PapaBear1981/Growshed/hardware/enclosure/node_enclosure_base.stl

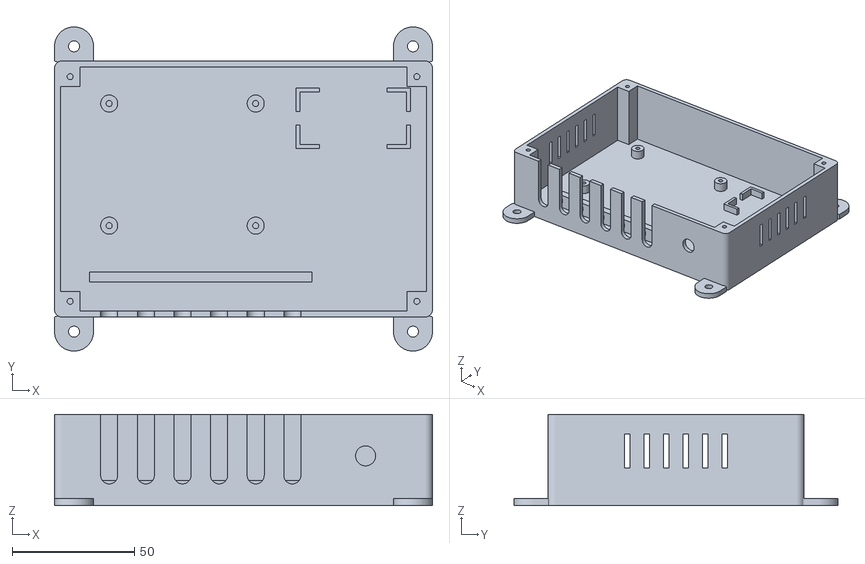
[picture p6: CAD file, 2026-11-10]
hardware/enclosure/node_enclosure_base.stl
154.8 x 132.8 x 37.4
