PapaBear1981/Growshed/hardware/enclosure/node_enclosure_lid.stl

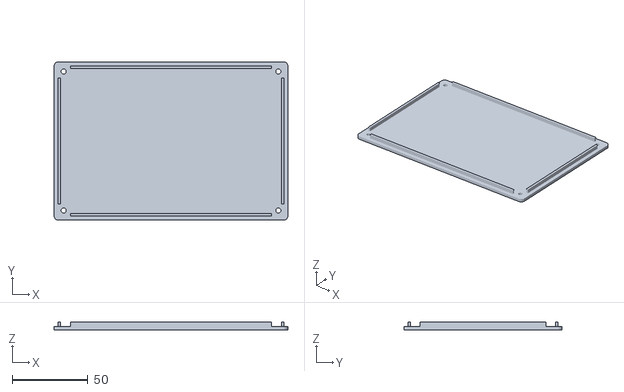
[picture p7: CAD file, 2026-11-10]
hardware/enclosure/node_enclosure_lid.stl
154.8 x 104.8 x 5.39
