PapaBear1981/Growshed/(commit log)

2026-11-10 Add project plan, architecture, safety rules, hardware and MQTT specs
    Planning docs for the Growshed controller (no code yet): phased build plan,
    Pi hub + ESPHome node architecture, node-enforced interlocks and fallbacks,
    power budget/BOM, MQTT topic contract, and CLAUDE.md for coding agents.
    Claude-Session: https://claude.ai/code/session_016ZEwZpMDaKmqs8DgSYCkPE
2026-11-10 Replan for grow tents in a finished basement
    Drop shed-specific planning (freeze protection, extension cords, insulation).
    Add per-tent nodes and zones, room humidity monitoring, spill containment,
    network-wide leak interlock, light overtemp cutoff, and basement power mapping.
    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
2026-11-10 Add printable node enclosure, node power design, and tent layout
    Parametric OpenSCAD enclosure (base + lid STLs) for an ESP32 breakout board,
    12V->5V buck converter and cable strain relief. Document 12V node power,
    the two 4x4 tents plus a dedicated tower tent, and move the tower pump and
    sensors to the tower tent's node.
    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
    [node_enclosure.scad, node_enclosure_base.stl, node_enclosure_lid.stl]
2026-11-11 Multi-board node firmware, USB board detection and GUI auto-discovery
    - firmware: ESPHome node configs (tent, tower tent, water; monitoring only)
    built from per-board profiles for ESP32, ESP32-S3, ESP32-C3, Arduino Nano
    ESP32 and ESP8266. Nodes never reboot on network loss.
    - tools/detect_boards: identify USB-connected boards and name the matching
    firmware profile, optionally probing the chip with esptool
    - GUI: boards not in config.yaml appear automatically with raw readings;
    System page shows board type and firmware; on/off states are judged by
    node liveness since ESPHome only publishes them on change
    - simulator: --extra-node to exercise discovery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
2026-11-11 Recognise Teensy boards in the USB detector
    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
2026-11-11 Phase 1: history storage and charts, alert engine, phone notifications
    - recorder: raw readings (30 d), 5-minute (1 y) and hourly summaries, with
    rollup, pruning and a grid-aligned history API
    - alerts: rule engine with hold/clear delays, unknown-state handling,
    acknowledge, repeat notifications and restart recovery; rules for leaks,
    low reservoirs, tent and water temperature, humidity, offline nodes,
    fallback mode and silent sensors
    - notify: ntfy delivery with retry, test endpoint, optional dead man's ping
    - GUI: History page (uPlot), Alerts page, critical banner on every page
    Claude-Session: https://claude.ai/code/session_0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
2026-11-11 Add build guide, generated wiring diagrams and notification setup
    - docs/BUILD.md: parts, soldering tips, bench tests, assembly, checks and
    troubleshooting for the Phase 1 sensor nodes
    - tools/wiring_diagrams: draws docs/wiring/*.svg from the firmware board
    profiles; a test fails if the committed diagrams go stale
    - ntfy and healthcheck settings in .env.example, compose and the Pi setup
    script; deploy README explains phone setup
    - recommend comparator leak-sensor modules over bare probes
    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
    [test_wiring_diagrams.py]
2026-11-11 Soil pots: moisture sensing, GUI calibration, alert, and watering rules
    - firmware: soil_sensor package (raw volts, median-filtered) and analog pin
    names in the board profiles; tent2 carries four pots by default
    - backend: two-point calibration stored in SQLite and applied to live
    values, history output and alerts; uncalibrated sensors have no value
    - GUI: soil readings on the dashboard, calibration controls on the System
    page, soil moisture chart
    - simulator: drying pots and soil faults
    - docs: wiring diagram and build steps for soil sensors; safety limits for
    Phase 2 automatic watering recorded in SAFETY.md
    Claude-Session: h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
2026-11-11 Phase 2 firmware: node-side control, interlocks and dosing limits
    - common/control.h: pure C++ control logic (mode/fallback/interlock decision,
    light window, thermostats, over-temperature latch, dose limiter) with
    native unit tests run from pytest
    - device and dose_device packages; control packages for tents (lights,
    exhaust, I-4/I-5), tower pump (I-7/I-10), water node (heater, pumps,
    top-off, I-1/2/3/8/9/10) and soil watering pumps (I-10/11/12)
    - hub leak alarm subscription, last_interlock, time zone from secrets
    - output pin names in the board profiles
    tent2, tent3 and water compile for the ESP32 DevKit.
    Claude-Session: http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
    [control_test.cpp]
2026-11-11 Phase 2 hub: device modes, settings, leak alarm latch and soil watering
    - control: auto/on/off modes with expiry, range-checked node settings, dose
    requests, and the latched house-wide leak alarm (I-10)
    - watering: dose-based auto-watering per pot with soak wait, response check,
    strike lockout, daily cap and trust checks on the reading (SAFETY 4b)
    - alerts for interlocks taking control, lights on but dark, the leak latch
    and stopped auto-watering
    - REST endpoints and WebSocket updates for the Controls page
    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
2026-11-11 Phase 2 docs: output wiring diagrams, build steps and updated specs
    - wiring diagram generator draws output diagrams (relay boxes, MOSFET
    boards) alongside the sensor diagrams; tank float added to tent2
    - BUILD.md: wiring and checking outputs, 12 V pumps, anti-siphon
    - SAFETY/ARCHITECTURE/MQTT/PLAN updated for node-local automation, the
    control topics and what is still unproven on hardware
    - firmware README: output pins, sensor-only boards, time zone
    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
2026-11-11 General sensor calibration: pH, EC, soil and offsets with steady capture
    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
2026-11-11 Phase 3 groundwork: cheap pH/EC probes, air sensor options, dosing log, journal
    - firmware: chemistry package for analog pH and TDS/EC boards (EC board
    powered only while read, so it cannot disturb pH); selectable air sensor
    packages (SHT4x, AHT20, BME280); faster soil publishing. Water node and
    AHT20/BME280 tent variants compile.
    - backend: manual dosing log, plants and journal with validated photo
    upload; pH/EC alert rules; calibration-due reminders
    - simulator: pH/EC probes with buffer and solution faults
    - GUI: general calibration component with steady-reading capture
    Claude-Session: https://claude.ai/code/session_016ZEwZp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
2026-11-11 Phase 3: Water and Journal pages, pH/EC charts, chemistry wiring and docs
    - GUI: Water page (pH, EC, temperature against targets, dosing log),
    Journal page (plants, notes, photos shrunk in the browser), pH and EC
    history with markers for logged additions, calibration display fixes
    - capture judges only the newest readings so moving a probe between
    solutions does not stall
    - wiring diagram for the pH and EC boards; BUILD.md section with the 5 V
    divider, calibration order and troubleshooting
    - docs rewritten around cheap hobby probes and their limits; stricter
    Phase 4 dosing rules for them
    Claude-Session: https://claude.ai/cod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
    [test_wiring_diagrams.py]
2026-11-11 Phase 4 firmware and simulator: dosing node with millilitre limits
    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
2026-11-11 Phase 4 hub: pH and nutrient dosing with suggest and auto modes
    Off by default. Suggest proposes one small dose for a person to approve;
    auto must be explicitly acknowledged server-side. Enforces mixing wait,
    opposing-pH hour, A-then-B nutrients, daily caps with lockout, response
    check with strike lockout, and refuses on untrusted readings (uncalibrated,
    overdue, stale, unsteady, jumping, too few), no circulation, low reservoir,
    leak, or offline nodes. Pump priming and flow-rate calibration.
    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
2026-11-11 Phase 4: dosing panel with automatic-mode warning, wiring and docs
    - GUI: dosing panel on the Water page (Off / Suggest / Automatic, suggestion
    with Approve / Not now, manual doses, pump priming and flow calibration,
    re-enable after a lockout). Automatic needs Continue in a warning dialog
    that says incorrect dosing can kill the plants; Cancel and Escape do nothing
    - dosing node wiring diagram; BUILD.md section on building and testing with
    plain water first
    - SAFETY/PLAN/MQTT/ARCHITECTURE/HARDWARE updated for dosing as built
    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
2026-11-11 Hub: editable limits, crop profiles, device history, reminders, grows, backups, digest
    - tunables: alert limits per zone, dosing targets and dose sizes, watering
    thresholds, device wattage and electricity price, range-checked and never
    above the dosing caps; crop profiles fill them in for one zone
    - device on/off history and an energy estimate from on-time x wattage
    - maintenance reminders and dosing bottle levels, with alerts
    - grows: one record per grow with statistics frozen when it ends
    - nightly database/config snapshots and a full zip export
    - daily summary notification and quiet hours (critical alerts never held)
    Claude-Ses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
2026-11-12 GUI: settings, grow history, kiosk view, theme choice, chart timelines
    - Settings page: units, light/dark per device, time zone, daily summary and
    quiet hours, limits and targets with crop profiles, reminders, electricity,
    backups
    - Grows page: start and end grows, live and frozen statistics, harvest
    weight, link to charts for the grow's whole period
    - Charts: fixed date ranges from the address, device on/off timelines
    aligned with the time axis
    - Kiosk view for the wall tablet; dashboard to-do list for due maintenance;
    bottle levels in the dosing panel; plants can belong to a grow
    - docs: what can be changed from the GUI, backups and restore, plan status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
